RevLmt/camboard-uno-q/assets/camboard_bottomview.png

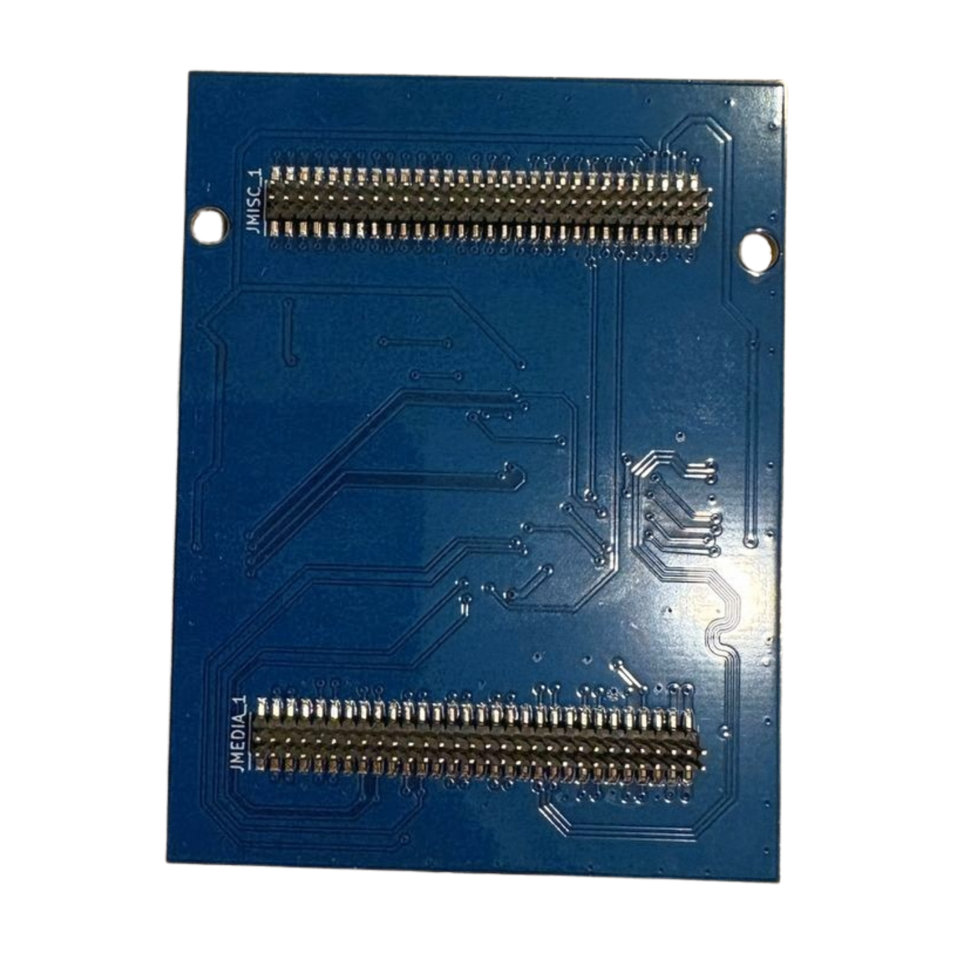
assets/camboard_bottomview.png
