RevLmt/camboard-uno-q/assets/camboard_camera1.png

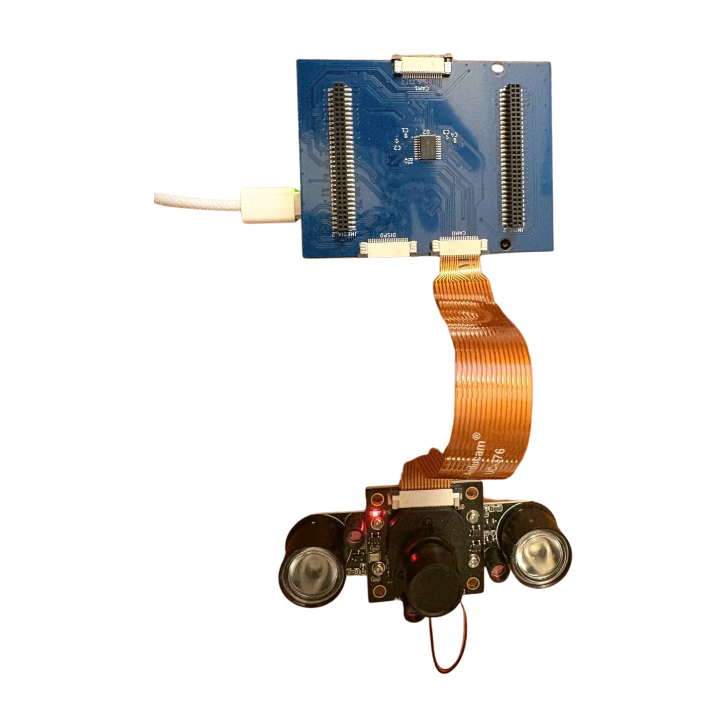
assets/camboard_camera1.png
