RevLmt/camboard-uno-q/assets/camboard_topview.png

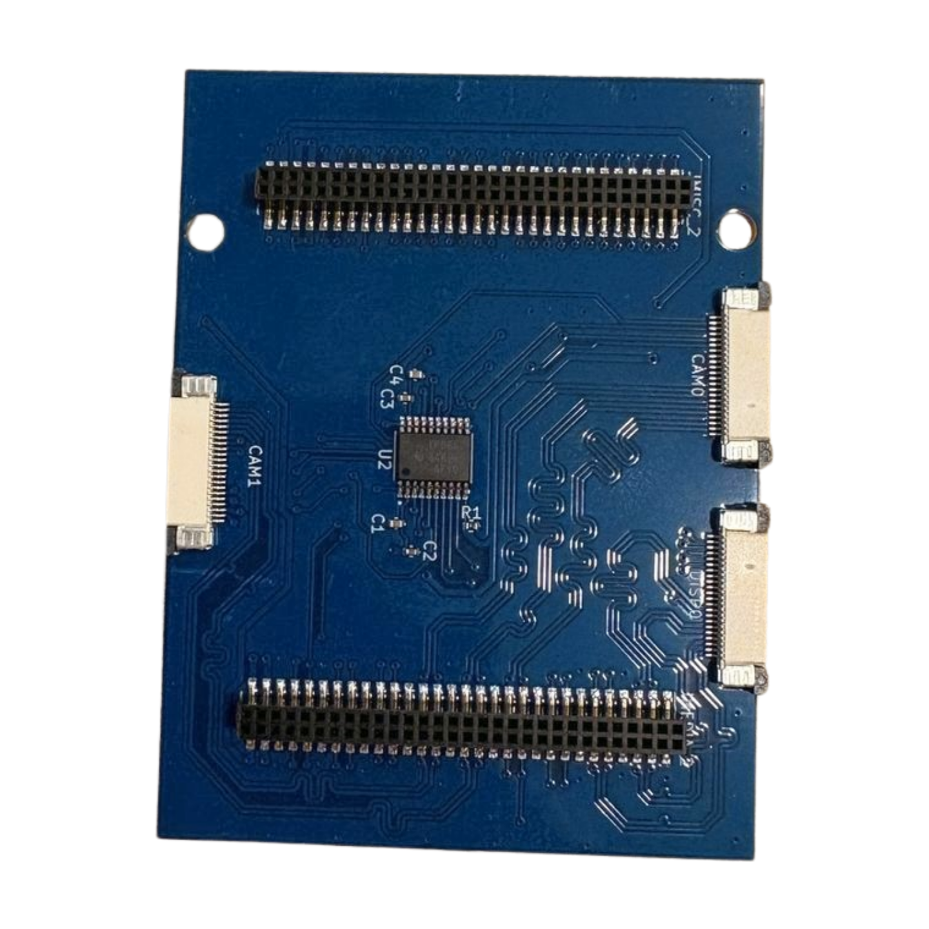
assets/camboard_topview.png
