RevLmt/camboard-uno-q/(commit log)

2025-12-12 Initial connectors and libs
    [camboard-uno-q.kicad_pcb, camboard-uno-q.kicad_sch]
2025-12-13 basic CSI layout w level shift
    [camboard-uno-q.kicad_sch]
2025-12-15 schematic with headers
    headers (top and bottom) done. Changed to 8-channel TXS level shifter.
    [camboard-uno-q.kicad_sch]
2025-12-15 beginning packaging
    [camboard-uno-q.kicad_sch]
2025-12-15 some footprints
2025-12-26 Basic routing
    Before length matching
    [camboard-uno-q.kicad_pcb, camboard-uno-q.kicad_sch]
2025-12-26 pair matching
    [camboard-uno-q.kicad_pcb]
2025-12-26 fixed board dims and position
    [camboard-uno-q.kicad_pcb]
2025-12-27 First DFM - close
    [camboard-uno-q.kicad_pcb]
2025-12-27 Ready for quoting
    [camboard-uno-q.kicad_pcb, camboard-uno-q.kicad_sch]
2025-12-27 Final Quote
    [camboard-uno-q.kicad_pcb, camboard-uno-q.kicad_sch]
2026-02-02 device tree info
2026-02-02 Intro note to README
    Added a description of the camera and display module along with a note about upcoming documentation.
2026-05-15 Add device tree overlay for imx219 power
